rivotmotors-rnd/ECU_Firmware_V3/ECU_Firmware_v3.0/README.md

# RIVOT-ECU-Firmware
RIVOT ECU firmware for STM32-based vehicle control systems
