rivotmotors-rnd/ECU_Firmware_V3/ECU_Hardware_v3.0/ECU.kicad_pcb

## KiCad design ECU_Hardware_v3.0/ECU.kicad_pcb (2026-10-08)

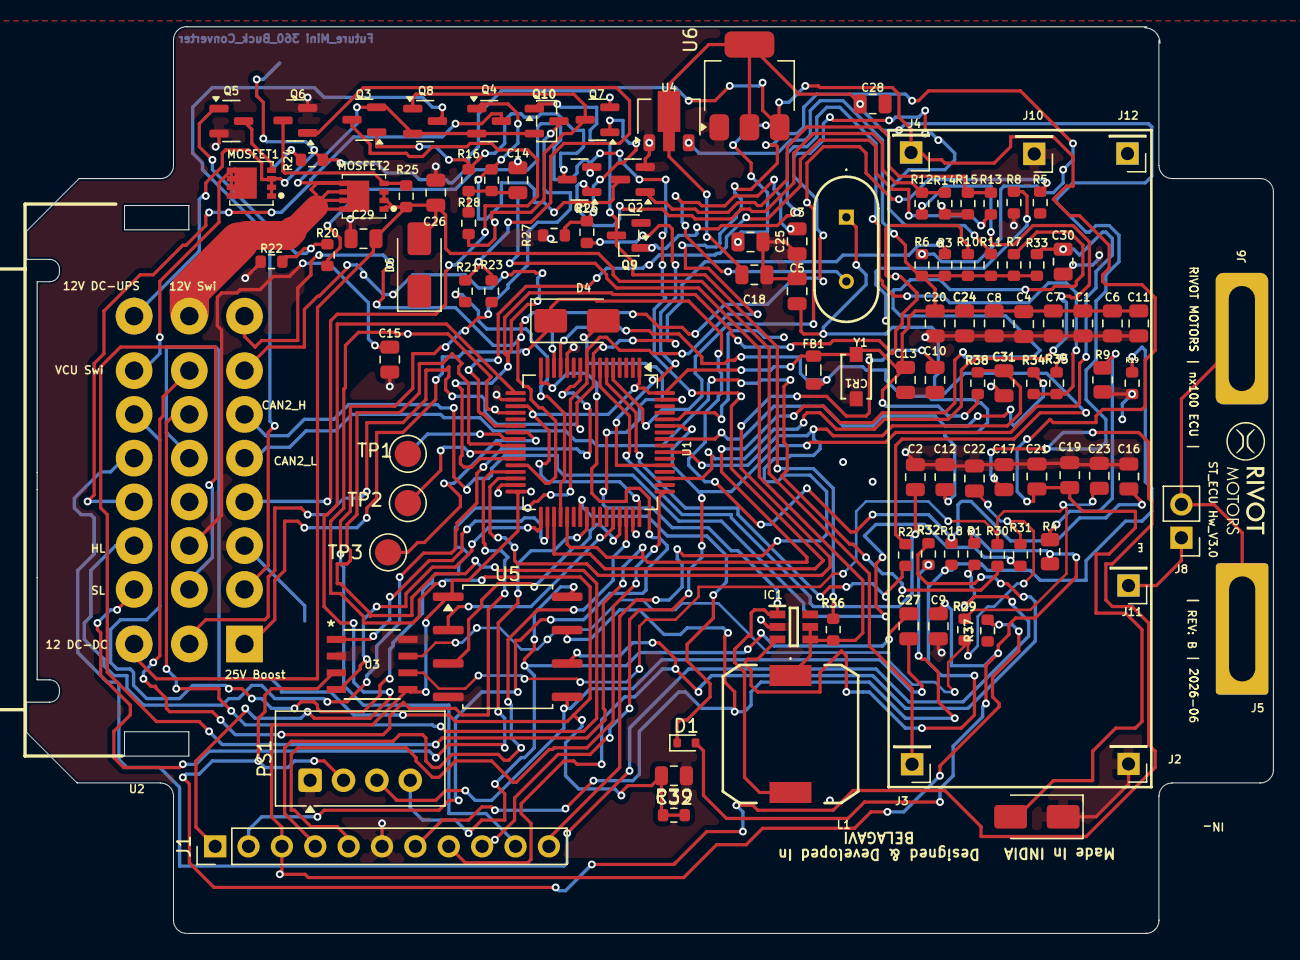
[picture p1: board ECU.kicad_pcb from above]

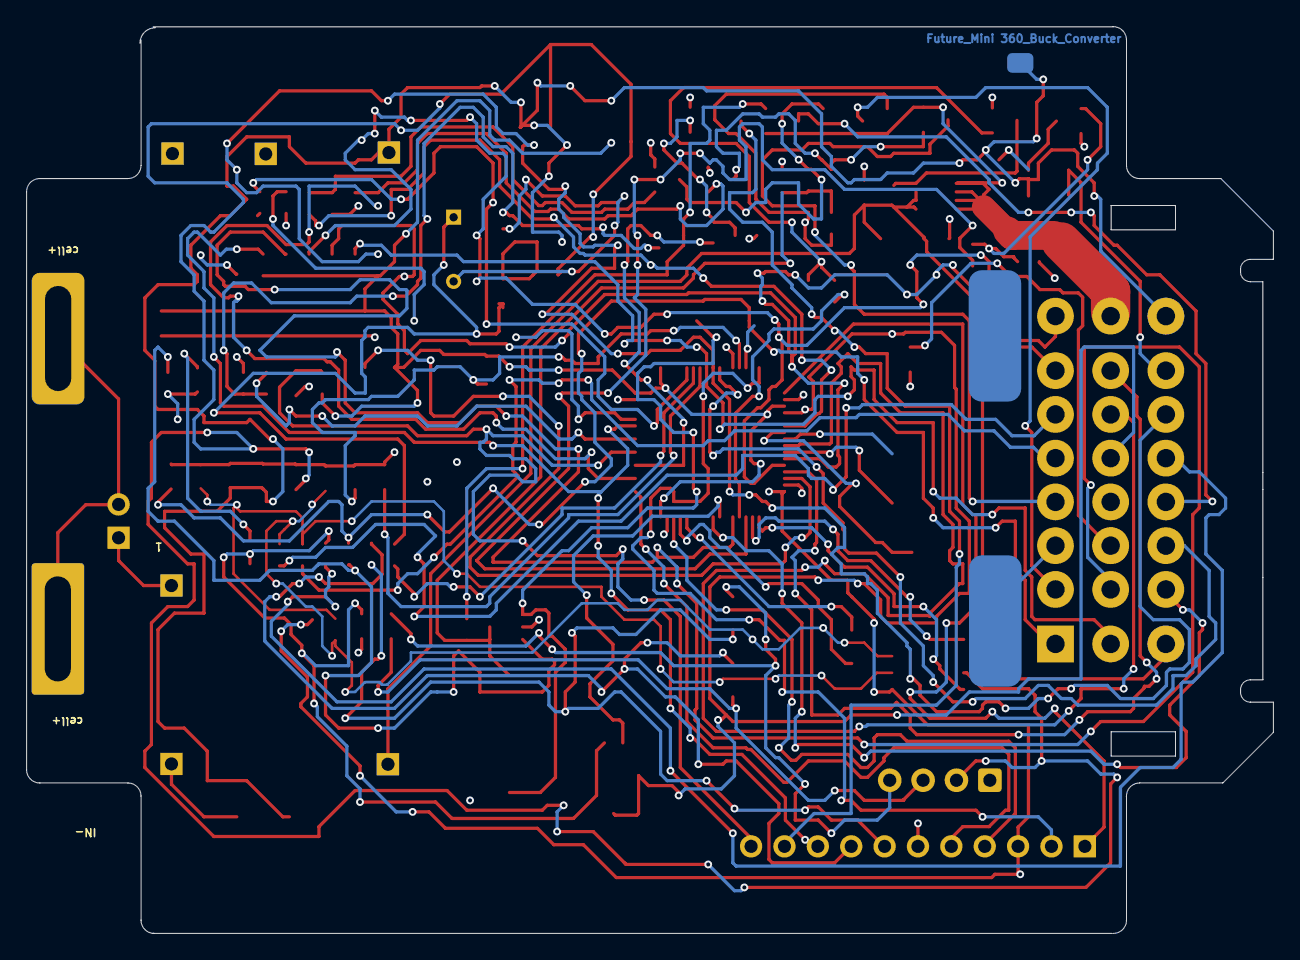
[picture p2: board ECU.kicad_pcb from below]

Board: 2 copper layers, 94.9 x 69.0 mm, 114 parts (2 on the bottom side), 78 nets.

Parts:
C1: 10uF; C_0805_2012Metric
C2, C4, C6, C7, C8, C9, C11, C12, C15, C17, C19, C21, C22, C23, C26, C29, C30, C31, C32: 0.1uF; C_0805_2012Metric
C3, C5: 20pF; C_0805_2012Metric
C10: 4.7uF; C_0805_2012Metric
C13: 1uF; C_0805_2012Metric
C14, C16, C18, C20, C25, C28: 22uF; C_0805_2012Metric
C24, C27: 0.1 uF; C_0805_2012Metric
CR1: SMF3.3; CR_SOD-123FL_LTF
D1: 1N4148WT- 1V 50mA; D_SOD-523
D4: SS34; D_SMA
D5, D6: SMAJ13CA; D_SMA
FB1: 600R; L_0805_2012Metric
IC1: MT3608; SOT95P280X145-6N
J1: Conn_01x11; PinHeader_1x11_P2.54mm_Vertical
J2: IN -; PinHeader_1x01_P2.54mm_Vertical
J3: IN +; PinHeader_1x01_P2.54mm_Vertical
J4: DC UPS out; PinHeader_1x01_P2.54mm_Vertical
J5: Cell J1; PinHeader_1x01_P2.54mm_Vertical
J6: Cell J2; PinHeader_1x01_P2.54mm_Vertical
J8: Conn_01x02_Pin; PinHeader_1x02_P2.54mm_Vertical
J10: OUT -; PinHeader_1x01_P2.54mm_Vertical
J11: Bat +; PinHeader_1x01_P2.54mm_Vertical
J12: BAT -; PinHeader_1x01_P2.54mm_Vertical
J13, J14: BAT -; TestPoint_Pad_1.0x1.0mm
L1: 47uH CDRH104RT125NP; CDRH104RT125NP220MC
MOSFET1, MOSFET2: DMP3007SFG-7
PS1: B0505S-1W; Converter_DCDC_TRACO_TBA1-xxxx_THT
Q1, Q2, Q5, Q6, Q7, Q9: AO3400A; SOT-23
Q3, Q4, Q8, Q10: AO3401A; SOT-23
R1, R3, R6, R7, R8, R10, R11, R14, R15, R16, R17, R19, R22, R23, R24, R25, R27, R28, R35, R36: 10K; R_0603_1608Metric
R2, R5: 0R; R_0603_1608Metric
R4: 2.2K; R_0805_2012Metric
R9: 1.5K; R_0805_2012Metric
R12, R13, R20, R21, R26, R34: 1K; R_0603_1608Metric
R18: 390K; R_0603_1608Metric
R29, R32: 120R; R_0603_1608Metric
R30, R31: 0; R_0603_1608Metric
R33, R37, R38: 10k; R_0603_1608Metric
R39: 100; R_0603_1608Metric
TP1, TP2, TP3: TestPoint; TestPoint_Keystone_5000-5004_Miniature
U1: STM32F446RETx; LQFP-64_10x10mm_P0.5mm
U2: 针座灰DJ7241-1.5 2.8-10; CONN-TH_DJ7241-1.5-2.8-10
U3: TJA1051T/3/1J; SO8_SOT96-1_NXP
U4: HT7333-1-SOT89; SOT-89-3
U5: ISO1050DUB; SOP-8_6.62x9.15mm_P2.54mm
U6: AMS1117-5.0; SOT-223-3_TabPin2
Y1: Crystal; X49ST28000F20JGDTD

Connections:
12V DC UPS O/P: C19.2, C21.2, C25.2, D5.2 (A2), J4.1 (Pin_1_1), MOSFET1.1 (S), MOSFET1.2 (S), MOSFET1.3 (S), R24.2, U2.24, U6.3 (VI)
12V DC-DC: C26.2, C29.2, D6.2 (A2), J3.1 (Pin_1_1), MOSFET2.1 (S), MOSFET2.2 (S), MOSFET2.3 (S), R25.2, U2.17
12V_Swi_Con: C14.2, IC1.4 (EN), IC1.5 (IN), L1.1, MOSFET2.5 (D), MOSFET2.6 (D), MOSFET2.7 (D), MOSFET2.8 (D), Q3.2 (S), Q4.2 (S), Q8.2 (S), Q10.2 (S), R16.2, R17.2, R28.2, R36.2, U2.16
+3.3V: C1.2, C4.2, C6.2, C7.2, C8.2, C11.2, C13.2, C20.2, C24.1, CR1.2, FB1.2, J1.3, R3.2, R6.1, R7.2, R10.2, R11.1, R33.1, R37.2, R38.2, U1.1 (VBAT), U1.19 (VDD), U1.32 (VDD), U1.48 (VDD), U1.64 (VDD), U3.5 (VIO), U4.3 (VOUT), U5.1 (VCC1)
+3.3VA: C12.2, FB1.1, U1.13 (VDDA)
+5V: C17.2, C18.2, C28.2, PS1.2 (VIN), U3.3 (VCC), U4.2 (VIN), U6.2 (VO)
/BOOT0: R8.2, U1.60 (BOOT0)
/ESD Protection, TVS diode , low pass filter, 3.3 buck conversion/CAN_N: C23.2, R29.2, R30.1, U3.6 (CANL)
/ESD Protection, TVS diode , low pass filter, 3.3 buck conversion/CAN_P: C22.2, R29.1, R31.1, U3.7 (CANH)
AUX A: C31.2, J1.11, R38.1, U1.55 (PB3)
BAT +: J8.1, J11.1 (Pin_1_1)
Boost_25V_Controller: C16.2, D4.1 (K), R18.1, U2.1
Brake_Regen_IP: C15.2, R37.1, U1.14 (PA0), U2.11
Brake_Regen_Op: C32.2, R39.1, R39.2, U1.20 (PA4), U2.13
Btn_Hazardlight_IP: R7.1, U1.37 (PC6), U2.10
Btn_HighBeam_IP: R1.1, U2.21
Btn_LHIndicator_IP: R3.1, U1.8 (PC0), U2.9
Btn_OffIndicator_IP: R11.2, U1.28 (PB2), U2.8
Btn_RHIndicator_IP: R10.1, U1.27 (PB1), U2.7
Btn_Seatlock_IP: R6.2, U1.9 (PC1), U2.22
CAN1_H: J1.7, R32.1, U5.7 (CANH)
CAN1_L: J1.8, R32.2, U5.6 (CANL)
CAN2_RX: U1.33 (PB12), U3.4 (RXD)
CAN2_TX: U1.34 (PB13), U3.1 (TXD)
CANH: R31.2, U2.6
CANL: R30.2, U2.5
CP Detect_IP: C30.2, J1.9, R33.2, U1.59 (PB7)
CRX1: U1.44 (PA11), U5.2 (RXD)
CTX1: U1.45 (PA12), U5.3 (TXD)
Contactor Pin 12V+: J1.10, Q10.3 (D)
Contactor_Sig_OP: R34.1, U1.57 (PB5)
HndlLock_Sig_OP: U1.10 (PC2), U2.19
LH_Indicator_Sig_Con: Q3.3 (D), U2.4
LH_Indicator_Sig_OP: R12.1, U1.51 (PC10)
MCU_U2DEBUG_RX: J1.1, U1.17 (PA3)
MCU_U2DEBUG_TX: J1.2, U1.16 (PA2)
MCU_UART3_RX: U1.25 (PC5), U2.14
MCU_UART3_TX: U1.29 (PB10), U2.15
unnamed: C3.2, R5.1, Y1.2
unnamed: C5.2, R2.1, Y1.1
unnamed: C9.1, D1.2 (A), R1.2, R4.1
unnamed: D1.1 (K), U1.39 (PC8)
unnamed: D4.2 (A), IC1.1 (SW), L1.2
unnamed: IC1.3 (FB), R18.2, R19.2
unnamed: J5.1 (Pin_1_1), J6.1 (Pin_1_1), J8.2
unnamed: MOSFET1.4 (G), Q5.3 (D), R24.1
unnamed: MOSFET2.4 (G), Q6.3 (D), R25.1
unnamed: C27.2, PS1.3 (0V), U5.5 (GND2)
unnamed: C27.1, PS1.4 (+VO), U5.8 (VCC2)
unnamed: Q1.3 (D), Q3.1 (G), R16.1
unnamed: Q1.1 (G), R12.2, R14.1
unnamed: Q2.3 (D), Q4.1 (G), R17.1
unnamed: Q2.1 (G), R13.2, R15.1
unnamed: Q5.1 (G), R20.2, R22.1
unnamed: Q6.1 (G), R21.2, R23.1
unnamed: Q7.3 (D), Q8.1 (G), R28.1
unnamed: Q7.1 (G), R26.2, R27.1
unnamed: Q9.1 (G), R34.2, R35.1
unnamed: Q9.3 (D), Q10.1 (G), R36.1
unnamed: R4.2, R9.1
unnamed: C2.2, U1.7 (NRST)
unnamed: TP3.1 (1_1), U1.23 (PA7)
unnamed: TP2.1 (1_1), U1.26 (PB0)
unnamed: TP1.1 (1_1), U1.24 (PC4)
unnamed: R5.2, U1.5 (PH0)
unnamed: R2.2, U1.6 (PH1)
unnamed: C10.1, U1.30 (VCAP_1)
OUT -: C1.1, C2.1, C3.1, C4.1, C5.1, C6.1, C7.1, C8.1, C9.2, C10.2, C11.1, C12.1, C13.1, C14.1, C15.1, C16.1, C17.1, C18.1, C19.1, C20.1, C21.1, C22.1, C23.1, C24.2, C25.1, C26.1, C28.1, C29.1, C30.1, C31.1, C32.1, CR1.1, D5.1 (A1), D6.1 (A1), IC1.2 (GND), J1.6, J2.1 (Pin_1_1), J10.1 (Pin_1_1), J12.1 (Pin_1_1), J13.1 (Pin_1_1), J14.1 (Pin_1_1), PS1.1 (GND), Q1.2 (S), Q2.2 (S), Q5.2 (S), Q6.2 (S), Q7.2 (S), Q9.2 (S), R8.1, R9.2, R14.2, R15.2, R19.1, R22.2, R23.2, R27.2, R35.2, U1.12 (VSSA), U1.18 (VSS), U1.31 (VSS), U1.47 (VSS), U1.63 (VSS), U2.3, U3.2 (GND), U3.8 (S), U4.1 (GND), U5.4 (GND1), U6.1 (GND)
RH_Indicator_Sig_Con: Q8.3 (D), U2.2
RH_Indicator_Sig_OP: R26.1, U1.53 (PC12)
SWCLK: J1.5, U1.49 (PA14)
SWIO: J1.4, U1.46 (PA13)
SeatLock_Sig_OP: U1.40 (PC9), U2.18
Switching_12V: R21.1, U1.36 (PB15)
Tail-lamp_Sig_Con: Q4.3 (D), U2.20
Tail-lamp_Sig_OP: R13.1, U1.22 (PA6)
VCU_Sig_Con: MOSFET1.5 (D), MOSFET1.6 (D), MOSFET1.7 (D), MOSFET1.8 (D), U2.23
VCU_Sig_OP: R20.1, U1.35 (PB14)
