rivotmotors-rnd/ECU_Firmware_V3/ECU_Firmware_v3.0/Core/Src/main.c

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
/* Includes ------------------------------------------------------------------*/
#include "main.h"
#include "cmsis_os.h"

/* USER CODE BEGIN Includes */
#include "FreeRTOS.h"
#include "ecu_actuators.h"
#include "ecu_can.h"
#include "ecu_tasks.h"
#include "ecu_types.h"
#include "ecu_uart.h"
#include "task.h"
#include <stdio.h>
#include <string.h>

/* USER CODE END Includes */

/* USER CODE BEGIN PD */
#define RX_SIZE 64
#define PING_PONG_COUNT 2
#define TX_BYTE_QUEUE_SIZE 8192
/* USER CODE END PD */

ADC_HandleTypeDef hadc1;
DAC_HandleTypeDef hdac;

CAN_HandleTypeDef hcan1;
CAN_HandleTypeDef hcan2;

IWDG_HandleTypeDef hiwdg;

UART_HandleTypeDef huart3;
DMA_HandleTypeDef hdma_usart3_rx;

/* Definitions for defaultTask */
osThreadId_t defaultTaskHandle;
const osThreadAttr_t defaultTask_attributes = {
    .name = "defaultTask",
    .stack_size = 128 * 4,
    .priority = (osPriority_t)osPriorityNormal,
};
/* USER CODE BEGIN PV */
/* Manually declared USART2 handle since CubeMX skips it */
UART_HandleTypeDef huart2;

/* DMA reception buffer (ping-pong) */
uint8_t rx_buf[PING_PONG_COUNT][RX_SIZE];
volatile uint8_t current_dma_buffer = 0;

/* TX interrupt byte queue for CAN-to-UART & Telemetry */
volatile uint8_t tx_ongoing = 0;
uint8_t tx_byte_queue[TX_BYTE_QUEUE_SIZE];
volatile uint16_t tx_byte_head = 0;
volatile uint16_t tx_byte_tail = 0;

/* can1_is_running tracks the power state of the Charger CAN bus.
 * Initialized to 1 because MX_CAN1_Init() starts the peripheral.
 * CanHealthMonitorTask exclusively manages this flag and the CAN1
 * Start/Stop lifecycle to eliminate EXTI bounce bugs. */
volatile uint8_t can1_is_running = 1;
/* USER CODE END PV */

void SystemClock_Config(void);
static void MX_GPIO_Init(void);
static void MX_DMA_Init(void);
static void MX_USART3_UART_Init(void);
static void MX_CAN2_Init(void);
static void MX_ADC1_Init(void);
static void MX_DAC_Init(void);
static void MX_CAN1_Init(void);
static void MX_IWDG_Init(void);
void StartDefaultTask(void *argument);

/* USER CODE BEGIN PFP */
/* Custom USART2 initialization to bypass CubeMX restrictions on PA3 */
void Custom_USART2_UART_Init(void);
void kick_tx(void);
void MX_FREERTOS_Init(void);
/* USER CODE END PFP */

/* USER CODE BEGIN 0 */

void kick_tx(void) {
  if (!tx_ongoing && (tx_byte_head != tx_byte_tail)) {
    tx_ongoing = 1;
    SET_BIT(huart3.Instance->CR1, USART_CR1_TXEIE);
  }
}

/**
 * @brief  Boot-time hardware self-test. Checks all PCB peripherals and pins
 *         before FreeRTOS starts. Reports faults over UART so you can
 *         immediately identify wiring, soldering, or component issues.
 *         This function NEVER blocks — it only logs and returns.
 */
static void Run_Hardware_Diagnostics(void) {
  uint8_t warn_count = 0;

  /* Pet the watchdog immediately at the start of diagnostics.
   * IWDG started ticking in MX_IWDG_Init(). The printf() calls below
   * are blocking (USART2 @ 115200 baud). Each character = ~87us.
   * ~2000 chars total = ~174ms. Refreshing here gives a fresh 3-sec window. */
  HAL_IWDG_Refresh(&hiwdg);

  /* =========================================================================
   * CHECK 1: RESET CAUSE
   * Read RCC->CSR to identify why the MCU last reset.
   * CRITICAL: This tells you immediately if the Watchdog triggered a reset.
   * =========================================================================
   */
  uint32_t rcc_csr = RCC->CSR;
  /* Clear the reset flags for the next boot cycle */
  RCC->CSR |= RCC_CSR_RMVF;

  printf("\r\n--- HARDWARE SELF-TEST BEGIN ---"
         "-\r\n");

  if (rcc_csr & RCC_CSR_IWDGRSTF) {
    printf("[RESET] *** WATCHDOG TIMEOUT *** A FreeRTOS task stopped running "
           "or took too long!\r\n");
    warn_count++;
  } else if (rcc_csr & RCC_CSR_WWDGRSTF) {
    printf("[RESET] *** WINDOW WATCHDOG TIMEOUT ***\r\n");
    warn_count++;
  } else if (rcc_csr & RCC_CSR_SFTRSTF) {
    printf("[RESET] Cause: Software Reset (HAL_NVIC_SystemReset called)\r\n");
  } else if (rcc_csr & RCC_CSR_PINRSTF) {
    printf("[RESET] Cause: Pin Reset (NRST button or external reset)\r\n");
  } else if (rcc_csr & RCC_CSR_BORRSTF) {
    printf("[RESET] Cause: Brown-Out Reset (supply voltage dropped below "
           "threshold!)\r\n");
    warn_count++;
  } else if (rcc_csr & RCC_CSR_PORRSTF) {
    printf("[RESET] Cause: Power-On Reset (normal cold boot)\r\n");
  } else {
    printf("[RESET] Cause: Unknown\r\n");
  }

  /* =========================================================================
   * CHECK 2: CAN BUS HEALTH
   * CAN pins (PB12/PB13 for CAN2, PA11/PA12 for CAN1) are ALTERNATE FUNCTION.
   * HAL_GPIO_ReadPin() does NOT work on AF pins. We check CAN->MSR register.
   * CAN_MSR_INAK=0 means peripheral is in Normal (active) mode — that's good.
   * CAN_MSR_INAK=1 means it is still in Init mode — peripheral failed to start.
   * =========================================================================
   */
  if (!(CAN2->MSR & CAN_MSR_INAK)) {
    printf("[DIAG] CAN2 (PB12/PB13) : OK  - Bus Active (Normal Mode)\r\n");
  } else {
    printf("[DIAG] CAN2 (PB12/PB13) : FAIL - Stuck in Init Mode! Check "
           "PB12/PB13 traces and termination resistor.\r\n");
    warn_count++;
  }

  if (!(CAN1->MSR & CAN_MSR_INAK)) {
    printf("[DIAG] CAN1 (PA11/PA12) : OK  - Bus Active (Normal Mode)\r\n");
  } else {
    /* Check if CAN1 was intentionally stopped because the gun is unplugged */
    if (HAL_GPIO_ReadPin(GPIOA, GPIO_PIN_5) == GPIO_PIN_SET) {
      printf("[DIAG] CAN1 (PA11/PA12) : OK  - Sleeping (No gun on PA5, "
             "expected)\r\n");
    } else {
      printf("[DIAG] CAN1 (PA11/PA12) : FAIL - Stuck in Init Mode! Check "
             "PA11/PA12 traces.\r\n");
      warn_count++;
    }
  }

  /* =========================================================================
   * CHECK 3: USART3 (VCU LINK) PERIPHERAL HEALTH
   * PC5/PB10 are ALTERNATE FUNCTION pins — cannot use HAL_GPIO_ReadPin().
   * Check USART3->SR: TXE bit should be SET when peripheral is ready and idle.
   * =========================================================================
   */
  if (USART3->SR & USART_SR_TXE) {
    printf("[DIAG] USART3 VCU Link   : OK  - TX Register Empty (Ready)\r\n");
  } else {
    printf("[DIAG] USART3 VCU Link   : WARN - TX not ready at boot. Check "
           "PB10/PC5.\r\n");
    warn_count++;
  }

  /* =========================================================================
   * CHECK 4: BRAKE SWITCH INPUT (PA0) & REGEN DAC (PA4)
   * PA0 is the digital Push-to-Off brake switch (PULLUP, idle=LOW, pulled=HIGH).
   * PA4 is the DAC1 Channel 1 output driving the motor controller regen signal.
   * =========================================================================
   */
  GPIO_PinState brake_sw = HAL_GPIO_ReadPin(BRAKE_INP_GPIO_Port, BRAKE_INP_Pin);
  printf("[DIAG] Brake Sw   (PA0)  : %s%s\r\n",
         (brake_sw == GPIO_PIN_SET) ? "PULLED (HIGH)" : "RELEASED (LOW)",
         (brake_sw == GPIO_PIN_SET) ? " <-- WARN: brake lever pulled at boot!" : "");
  if (brake_sw == GPIO_PIN_SET)
    warn_count++;

  printf("[DIAG] Regen DAC  (PA4)  : OK   - Initialized at 0.8V (Brake Released setpoint)\r\n");

  /* =========================================================================
   * CHECK 5: SWITCH & INPUT PINS (all are plain GPIO INPUT — valid to read)
   * These are all configured PULLUP, so idle state = HIGH = GPIO_PIN_SET.
   * If any read LOW at boot, the switch is physically pressed/stuck/shorted.
   * HIGH_BEAM (PC8) is PULLDOWN, so idle = LOW = GPIO_PIN_RESET.
   * =========================================================================
   */
  /* Left Indicator Switch (PC0) — PULLUP, active LOW */
  GPIO_PinState sw;
  sw = HAL_GPIO_ReadPin(LEFT_INDICATOR_INP_PORT, LEFT_INDICATOR_INP_PIN);
  printf("[DIAG] Left  Sw   (PC0)  : %s%s\r\n",
         (sw == GPIO_PIN_RESET) ? "ON " : "OFF",
         (sw == GPIO_PIN_RESET) ? " <-- WARN: switch active at boot!" : "");
  if (sw == GPIO_PIN_RESET)
    warn_count++;

  /* Seat Button (PC1) — PULLUP, active LOW */
  sw = HAL_GPIO_ReadPin(BUTTON_LOCK_PORT, BUTTON_LOCK_PIN);
  printf("[DIAG] Seat  Btn  (PC1)  : %s%s\r\n",
         (sw == GPIO_PIN_RESET) ? "ON " : "OFF",
         (sw == GPIO_PIN_RESET) ? " <-- WARN: button held at boot!" : "");
  if (sw == GPIO_PIN_RESET)
    warn_count++;

  /* Hazard Switch (PC6) — PULLUP, active LOW */
  sw = HAL_GPIO_ReadPin(HAZARD_INP_PORT, HAZARD_INP_PIN);
  printf("[DIAG] Hazard Sw  (PC6)  : %s%s\r\n",
         (sw == GPIO_PIN_RESET) ? "ON " : "OFF",
         (sw == GPIO_PIN_RESET) ? " <-- WARN: hazard active at boot!" : "");
  if (sw == GPIO_PIN_RESET)
    warn_count++;

  /* Right Indicator Switch (PB1) — PULLUP, active LOW */
  sw = HAL_GPIO_ReadPin(RIGHT_INDICATOR_INP_PORT, RIGHT_INDICATOR_INP_PIN);
  printf("[DIAG] Right Sw   (PB1)  : %s%s\r\n",
         (sw == GPIO_PIN_RESET) ? "ON " : "OFF",
         (sw == GPIO_PIN_RESET) ? " <-- WARN: switch active at boot!" : "");
  if (sw == GPIO_PIN_RESET)
    warn_count++;

  /* Indicator Off Switch (PB2) — PULLUP, active LOW */
  sw = HAL_GPIO_ReadPin(OFF_INDICATOR_INP_PORT, OFF_INDICATOR_INP_PIN);
  printf("[DIAG] Ind Off    (PB2)  : %s%s\r\n",
         (sw == GPIO_PIN_RESET) ? "ON " : "OFF",
         (sw == GPIO_PIN_RESET)
             ? " <-- WARN: indicator off switch held at boot!"
             : "");
  if (sw == GPIO_PIN_RESET)
    warn_count++;

  /* High Beam / Ignition Sense (PC8) — PULLDOWN, active HIGH */
  sw = HAL_GPIO_ReadPin(HIGH_BEAM_PORT, HIGH_BEAM_PIN);
  printf("[DIAG] HighBeam   (PC8)  : %s\r\n",
         (sw == GPIO_PIN_SET) ? "ON" : "OFF");

  /* =========================================================================
   * CHECK 5b: CONTACTOR FEEDBACK (PB3 — PULLUP, active LOW)
   * PB3 is the Auxiliary Contact of the HV Contactor relay.
   * At boot, the MOSFET is OFF, so the contactor MUST be open.
   * Expected state = HIGH (3.3V via pull-up = contactor open = safe).
   * If PB3 reads LOW at boot, the contactor contacts are WELDED SHUT!
   * This is a critical hardware fault — HV battery is permanently connected.
   * =========================================================================
   */
  GPIO_PinState contactor_fb =
      HAL_GPIO_ReadPin(CONTACTOR_FEEDBACK_GPIO_Port, CONTACTOR_FEEDBACK_Pin);
  if (contactor_fb == GPIO_PIN_SET) {
    printf("[DIAG] Contactor  (PB3)  : OK   - Feedback HIGH (Contactor OPEN,"
           " safe)\r\n");
  } else {
    printf("[DIAG] Contactor  (PB3)  : FATAL - Feedback LOW! CONTACTOR MAY BE"
           " WELDED SHUT! HV IS LIVE!\r\n");
    warn_count++;
  }

  /* =========================================================================
   * CHECK 5c: CP LINE CHARGER GUN DETECT (PB7 — PULLUP, active LOW)
   * Gun Connected: LOW (CP and AUX2 shorted)
   * Gun Disconnected: HIGH
   * =========================================================================
   */
  GPIO_PinState cp_state =
      HAL_GPIO_ReadPin(CP_LINE_DETECT_GPIO_Port, CP_LINE_DETECT_Pin);
  printf("[DIAG] Charger CP (PB7)  : %s (Gun %s)\r\n",
         (cp_state == GPIO_PIN_RESET) ? "LOW " : "HIGH",
         (cp_state == GPIO_PIN_RESET) ? "CONNECTED" : "DISCONNECTED");

  /* =========================================================================
   * CHECK 6: MOSFET OUTPUT READBACK
   * Write a known state, read it back. If they differ, the output driver,
   * MOSFET gate, or trace has a fault (short, open, damaged FET).
   * VCU MOSFET (PB14) is set HIGH at boot. 12V Aux (PB15) is LOW at boot.
   * =========================================================================
   */
  GPIO_PinState vcu_out = HAL_GPIO_ReadPin(VCU_SIG_OP_PORT, VCU_SIG_OP_PIN);
  if (vcu_out == GPIO_PIN_SET) {
    printf("[DIAG] VCU  MOSFET(PB14) : OK   - Output HIGH (as expected)\r\n");
  } else {
    printf("[DIAG] VCU  MOSFET(PB14) : WARN - Output reads LOW! Expected HIGH. "
           "Check PB14 trace/FET gate.\r\n");
    warn_count++;
  }

  GPIO_PinState aux_out =
      HAL_GPIO_ReadPin(SWITCHING_12V_PORT, SWITCHING_12V_PIN);
  if (aux_out == GPIO_PIN_RESET) {
    printf("[DIAG] 12V  Aux   (PB15) : OK   - Output LOW  (as expected)\r\n");
  } else {
    printf("[DIAG] 12V  Aux   (PB15) : WARN - Output reads HIGH! Expected LOW. "
           "Check PB15 trace/FET gate.\r\n");
    warn_count++;
  }

  /* =========================================================================
   * CHECK 7: WATCHDOG (IWDG) CONFIRMATION
   * If MX_IWDG_Init ran successfully, the IWDG is running and cannot be
   * stopped. This is just a confirmation print. Presence of this log = IWDG is
   * armed.
   * =========================================================================
   */
  printf("[DIAG] IWDG Watchdog : ARMED (Prescaler=32, Reload=3000, "
         "Timeout~3s)\r\n");

  /* =========================================================================
   * SUMMARY
   * =========================================================================
   */
  if (warn_count == 0) {
    printf("--- SELF-TEST COMPLETE: ALL OK ---\r\n\r\n");
  } else {
    printf("--- SELF-TEST COMPLETE: %u WARNING(S) FOUND ---\r\n\r\n",
           warn_count);
  }
}

/* USER CODE END 0 */

/**
 * @brief  The application entry point.
 * @retval int
 */
int main(void) {

  /* MCU Configuration--------------------------------------------------------*/

  /* Reset of all peripherals, Initializes the Flash interface and the Systick.
   */
  HAL_Init();

  /* Configure the system clock */
  SystemClock_Config();

  /* Initialize all configured peripherals */
  MX_GPIO_Init();
  MX_DMA_Init();
  MX_USART3_UART_Init();
  MX_CAN2_Init();
  MX_ADC1_Init();
  MX_DAC_Init();
  MX_CAN1_Init();
  MX_IWDG_Init();
  /* USER CODE BEGIN 2 */
  /* Initialize USART2 for full duplex (PA2 TX, PA3 RX) */
  Custom_USART2_UART_Init();

  printf("\r\n================================\r\n");
  printf("  ECU BOOT SEQUENCE INITIATED   \r\n");
  printf("================================\r\n");
  printf("[SYS] GPIO + DMA + USART2 Initialized\r\n");
  printf("[SYS] DAC1 Initialized (Regen Control on PA4)\r\n");
  printf("[SYS] ADC1 Initialized\r\n");
  printf("[SYS] CAN1 + CAN2 Initialized\r\n");
  printf("[SYS] USART3 (VCU Comms) Initialized\r\n");
  printf("[SYS] IWDG Watchdog Initialized\r\n");

  /* Start CAN1 and CAN2 FIRST so the hardware diagnostic can accurately check
   * whether CAN left Init Mode. Previously this ran after diagnostics,
   * meaning INAK was always 1 (false FAIL). */
  hcan1.Instance->MCR |= CAN_MCR_ABOM;
  hcan2.Instance->MCR |= CAN_MCR_ABOM;

  CAN_FilterTypeDef sFilterConfig = {0};
  sFilterConfig.FilterBank = 14;
  sFilterConfig.FilterMode = CAN_FILTERMODE_IDMASK;
  sFilterConfig.FilterScale = CAN_FILTERSCALE_32BIT;
  sFilterConfig.FilterIdHigh = 0x0000;
  sFilterConfig.FilterIdLow = 0x0000;
  sFilterConfig.FilterMaskIdHigh = 0x0000;
  sFilterConfig.FilterMaskIdLow = 0x0000;
  sFilterConfig.FilterFIFOAssignment = CAN_RX_FIFO0;
  sFilterConfig.FilterActivation = ENABLE;
  sFilterConfig.SlaveStartFilterBank = 14;
  if (HAL_CAN_ConfigFilter(&hcan2, &sFilterConfig) != HAL_OK)
    Error_Handler();

  /* CAN1 Filter — Bank 0, accept ALL messages from Charger (CHAdeMO) */
  CAN_FilterTypeDef sCan1FilterConfig = {0};
  sCan1FilterConfig.FilterBank = 0;
  sCan1FilterConfig.FilterMode = CAN_FILTERMODE_IDMASK;
  sCan1FilterConfig.FilterScale = CAN_FILTERSCALE_32BIT;
  sCan1FilterConfig.FilterIdHigh = 0x0000;
  sCan1FilterConfig.FilterIdLow = 0x0000;
  sCan1FilterConfig.FilterMaskIdHigh = 0x0000;
  sCan1FilterConfig.FilterMaskIdLow = 0x0000;
  sCan1FilterConfig.FilterFIFOAssignment = CAN_RX_FIFO0;
  sCan1FilterConfig.FilterActivation = ENABLE;
  sCan1FilterConfig.SlaveStartFilterBank = 14;
  if (HAL_CAN_ConfigFilter(&hcan1, &sCan1FilterConfig) != HAL_OK)
    Error_Handler();

  /* Start CAN1 and CAN2 */
  if (HAL_CAN_Start(&hcan1) != HAL_OK)
    Error_Handler();
  if (HAL_CAN_Start(&hcan2) != HAL_OK)
    Error_Handler();

  /* Arm CAN1 RX interrupt unconditionally — the EXTI callback will stop/start
   * CAN1, but the notification must be armed from the beginning so it works
   * correctly when CAN1 is woken up at runtime */
  if (HAL_CAN_ActivateNotification(&hcan1, CAN_IT_RX_FIFO0_MSG_PENDING) !=
      HAL_OK)
    Error_Handler();

  /* Arm CAN2 RX interrupt */
  if (HAL_CAN_ActivateNotification(&hcan2, CAN_IT_RX_FIFO0_MSG_PENDING) !=
      HAL_OK)
    Error_Handler();

  /* Note: CAN1 power state (Start/Stop) and interrupt activation based on
   * the charger gun (CP line) is now exclusively managed by the
   * CanHealthMonitorTask in FreeRTOS to eliminate boot state bugs and
   * mechanical switch bouncing. CAN1 is started by default here via CubeMX,
   * but the RTOS task will shut it down within 100ms if no gun is present. */

  /* Run full hardware PCB self-test — CAN is now started so the diagnostic
   * will correctly report NORMAL mode instead of a false Init Mode FAIL */
  Run_Hardware_Diagnostics();

  /* Pet the watchdog after diagnostics completes. */
  HAL_IWDG_Refresh(&hiwdg);

  // Start DMA reception (same as V2 PCB)
  HAL_UART_Receive_DMA(&huart3, rx_buf[current_dma_buffer], RX_SIZE);
  __HAL_UART_ENABLE_IT(&huart3, UART_IT_IDLE);
  printf("[SYS] UART3 DMA RX Started & IDLE IT Enabled\r\n");

  DWT_Init();
  printf("[SYS] DWT Cycle Counter Initialized\r\n");
  printf("[SYS] Peripheral Initialization Complete. Starting FreeRTOS...\r\n");

  /* Pet the watchdog one final time before handing off to FreeRTOS.
   * osKernelInitialize() + MX_FREERTOS_Init() (9 tasks + 4 queues) can take
   * time. This ensures the scheduler starts within a fresh 3-second window.
   * After this, TelemetryHeartbeatTask takes over petting every 1000ms. */
  HAL_IWDG_Refresh(&hiwdg);
  /* USER CODE END 2 */

  /* Init scheduler */
  osKernelInitialize();

  /* USER CODE BEGIN RTOS_MUTEX */
  /* add mutexes, ... */
  /* USER CODE END RTOS_MUTEX */

  /* USER CODE BEGIN RTOS_SEMAPHORES */
  /* add semaphores, ... */
  /* USER CODE END RTOS_SEMAPHORES */

  /* USER CODE BEGIN RTOS_TIMERS */
  /* start timers, add new ones, ... */
  /* USER CODE END RTOS_TIMERS */

  /* USER CODE BEGIN RTOS_QUEUES */
  /* add queues, ... */
  /* USER CODE END RTOS_QUEUES */

  /* Create the thread(s) */
  /* creation of defaultTask */
  defaultTaskHandle =
      osThreadNew(StartDefaultTask, NULL, &defaultTask_attributes);

  /* USER CODE BEGIN RTOS_THREADS */
  /* add threads, ... */
  MX_FREERTOS_Init();
  /* USER CODE END RTOS_THREADS */

  /* USER CODE BEGIN RTOS_EVENTS */
  /* add events, ... */
  /* USER CODE END RTOS_EVENTS */

  /* Start scheduler */
  osKernelStart();

  /* We should never get here as control is now taken by the scheduler */

  /* Infinite loop */
  /* USER CODE BEGIN WHILE */
  while (1) {
    /* USER CODE END WHILE */

    /* USER CODE BEGIN 3 */
  }
  /* USER CODE END 3 */
}

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
/* USER CODE BEGIN 4 */
/* =========================================================================
 * USART2 INITIALIZATION (Full Duplex: PA2 TX, PA3 RX)
 * ========================================================================= */
void Custom_USART2_UART_Init(void) {
  /* 1. Enable Clocks */
  __HAL_RCC_USART2_CLK_ENABLE();
  __HAL_RCC_GPIOA_CLK_ENABLE();

  /* 2. Configure PA2 (TX) and PA3 (RX) as USART2 (Alternate Function 7) */
  GPIO_InitTypeDef GPIO_InitStruct = {0};
  GPIO_InitStruct.Pin = GPIO_PIN_2 | GPIO_PIN_3;
  GPIO_InitStruct.Mode = GPIO_MODE_AF_PP;
  GPIO_InitStruct.Pull = GPIO_PULLUP;
  GPIO_InitStruct.Speed = GPIO_SPEED_FREQ_VERY_HIGH;
  GPIO_InitStruct.Alternate = GPIO_AF7_USART2;
  HAL_GPIO_Init(GPIOA, &GPIO_InitStruct);

  /* 3. Initialize UART peripheral for full duplex (TX & RX) */
  huart2.Instance = USART2;
  huart2.Init.BaudRate = 115200;
  huart2.Init.WordLength = UART_WORDLENGTH_8B;
  huart2.Init.StopBits = UART_STOPBITS_1;
  huart2.Init.Parity = UART_PARITY_NONE;
  huart2.Init.Mode = UART_MODE_TX_RX;
  huart2.Init.HwFlowCtl = UART_HWCONTROL_NONE;
  huart2.Init.OverSampling = UART_OVERSAMPLING_16;
  if (HAL_UART_Init(&huart2) != HAL_OK) {
    Error_Handler();
  }
}

/**
 * @brief DAC Initialization Function (PA4 = DAC1 Channel 1)
 * Drives regenerative braking control voltage to motor controller.
 */
static void MX_DAC_Init(void) {
  DAC_ChannelConfTypeDef sConfig = {0};

  /* Enable DAC clock */
  __HAL_RCC_DAC_CLK_ENABLE();

  hdac.Instance = DAC;
  if (HAL_DAC_Init(&hdac) != HAL_OK) {
    Error_Handler();
  }

  /* Configure DAC channel 1 (PA4) */
  sConfig.DAC_Trigger = DAC_TRIGGER_NONE;
  sConfig.DAC_OutputBuffer = DAC_OUTPUTBUFFER_ENABLE;
  if (HAL_DAC_ConfigChannel(&hdac, &sConfig, DAC_CHANNEL_1) != HAL_OK) {
    Error_Handler();
  }

  /* Start DAC Channel 1 */
  HAL_DAC_Start(&hdac, DAC_CHANNEL_1);

  /* Set initial voltage: 0.8V (Brake Released setpoint) */
  HAL_DAC_SetValue(&hdac, DAC_CHANNEL_1, DAC_ALIGN_12B_R, BRAKE_REGEN_DAC_VAL_RELEASED);
}

/* Route printf output to UART2 (ESP32 debug link, TX only to PA2). */
int _write(int file, char *ptr, int len) {
  (void)file;
  HAL_UART_Transmit(&huart2, (uint8_t *)ptr, len, HAL_MAX_DELAY);
  return len;
}

/* Error Recovery Callback */
void HAL_UART_ErrorCallback(UART_HandleTypeDef *huart) {
  if (huart->Instance == USART3) {
    if (huart->ErrorCode &
        (HAL_UART_ERROR_ORE | HAL_UART_ERROR_NE | HAL_UART_ERROR_FE)) {
      __HAL_UART_CLEAR_OREFLAG(huart);
      __HAL_UART_CLEAR_NEFLAG(huart);
      __HAL_UART_CLEAR_FEFLAG(huart);
      HAL_UART_Receive_DMA(huart, rx_buf[current_dma_buffer], RX_SIZE);

      // Rate-limit the print to once every 5 seconds to prevent log flooding
      static uint32_t last_err_print = 0;
      if (HAL_GetTick() - last_err_print > 5000) {
        printf("[UART3] Error Recovered (Noise/Overrun/Disconnect)\r\n");
        last_err_print = HAL_GetTick();
      }
    }
  }
}

/**
 * @brief Hardware Interrupt Callback for GPIO Pins
 *        This fires instantly the exact millisecond the CHAdeMO gun is plugged
 * in or unplugged.
 */
void HAL_GPIO_EXTI_Callback(uint16_t GPIO_Pin) {}

/* USER CODE END 4 */

/* USER CODE BEGIN Header_StartDefaultTask */
/**
 * @brief  Function implementing the defaultTask thread.
 * @param  argument: Not used
 * @retval None
 */
/* USER CODE END Header_StartDefaultTask */
void StartDefaultTask(void *argument) {
  /* USER CODE BEGIN 5 */
  /* Infinite loop */
  for (;;) {
    osDelay(1);
  }
  /* USER CODE END 5 */
}

/**
 * @brief  This function is executed in case of error occurrence.
 * @retval None
 */
void Error_Handler(void) {
  /* USER CODE BEGIN Error_Handler_Debug */
  printf("\r\n[CRITICAL ERROR] Error_Handler() invoked! System halted.\r\n");
  /* User can add his own implementation to report the HAL error return state */
  __disable_irq();
  while (1) {
  }
  /* USER CODE END Error_Handler_Debug */
}
#ifdef USE_FULL_ASSERT
/**
 * @brief  Reports the name of the source file and the source line number
 *         where the assert_param error has occurred.
 * @param  file: pointer to the source file name
 * @param  line: assert_param error line source number
 * @retval None
 */
void assert_failed(uint8_t *file, uint32_t line) {
  /* USER CODE BEGIN 6 */
  /* User can add his own implementation to report the file name and line
     number, ex: printf("Wrong parameters value: file %s on line %d\r\n", file,
     line) */
  /* USER CODE END 6 */
}
#endif /* USE_FULL_ASSERT */
