rivotmotors-rnd/ECU_Firmware_V3/(commit log)

2026-10-08 chore: initialize RIVOT ECU V3.0 monorepo with firmware and hardware
    - ECU_Firmware_v3.0: STM32F446RE firmware with dual-CAN charging safety
    - ECU_Hardware_v3.0: KiCad V3 PCB schematic and layout
    - ECU_ESP32_Debug: ESP32 UART debug bridge
    - Added root .gitignore for STM32/KiCad/Python artifacts
    - Excluded internal documentation and scripts
    - Added .gitattributes for consistent LF line endings
    [ECU (1).kicad_sch, ECU.kicad_pcb]
2026-10-08 feat(bsp): update MCU pin mappings for ECU V3.0 hardware architecture
    - Reassign contactor auxiliary feedback from PA3 to PB3 (GPIO input with internal pull-up) to eliminate conflict with USART2 RX.
    - Reassign CP line charger gun detect from PA5 to PB7 (GPIO input with internal pull-up).
    - Configure PA0 as digital push-to-off brake switch input.
    - Configure PA4 as DAC_OUT1 for regenerative braking voltage output (0.8V idle, 2.5V active) and include STM32 HAL DAC drivers.
    - Enable full-duplex USART2 on PA2 (TX) and PA3 (RX).
    - Synchronize ECU_V3.ioc pinout, main.h, ecu_config.h, and board peripherals.
