rivotmotors-rnd/ECU_Firmware_V3/(notices)

Notices in the files:
ECU_Firmware_v3.0/Core/Inc/main.h:
Copyright (c) 2026 STMicroelectronics.
All rights reserved.
This software is licensed under terms that can be found in the LICENSE file
